maryane-castro/Spider-Robot/README.md

<h1 align="center">Spider Robot</h1>
<hr>
<p align="center">

</p>

<h2>Sobre o Projeto</h2>
<p>Desenvolvido em C, o projeto é destinado ao controlamento de um quadruped, sendo controlado por módulo bluetooh e arduino de forma embarcada.</p>

<h2>Tecnológias Usadas</h2>
<ul>
    <li>C</li>
    <li>IDE Arduino</li>
</ul>
